LopeWale/home-hub/hardware/home-hub-enclosure-REV8.3mf

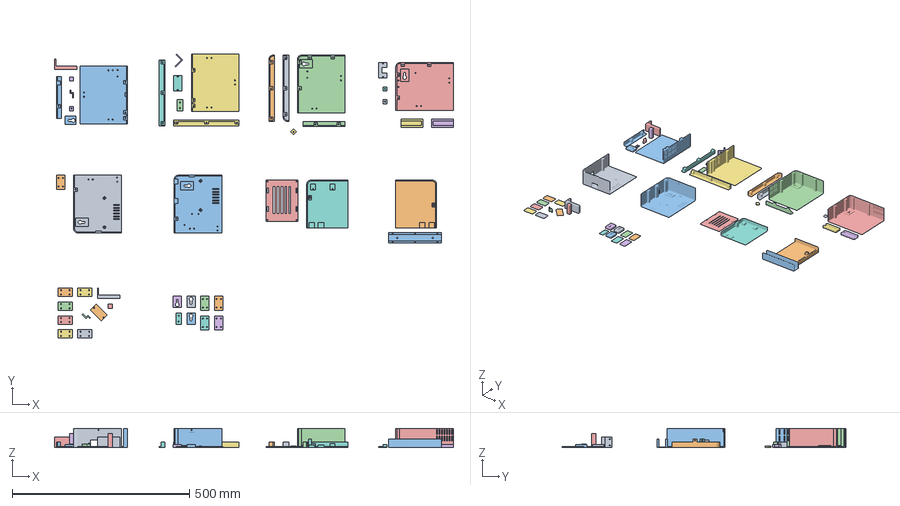
[picture p6: CAD file, 2026-10-14]
hardware/home-hub-enclosure-REV8.3mf
1124.1 x 800.8 x 54.0 mm
03-monitor-bottom-shoe.stl x 2
02-chassis-splice.stl x 11
01-rear-1-2.stl
04-monitor-rear-post.stl x 2
01-rear-2-2.stl
12-wall-spacer.stl x 4
13-exit-blank.stl x 2
01-rear-1-1.stl
01-rear-2-1.stl
11-bay-cover-splice.stl x 2
01-rear-1-3.stl
01-rear-2-3.stl
10-right-bay-cover-2.stl
10-right-bay-cover-1.stl
14-wall-cable-channel.stl
11-bay-cover-hook.stl x 2
12-wall-anti-lift-bracket.stl
08-front-bottom-right.stl
07-front-top-right.stl
08-front-bottom-left.stl
07-front-top-left.stl
09-front-left-lower.stl
09-front-left-upper.stl
06-open-pi-carrier.stl
04-monitor-side-stop-right.stl
04-monitor-side-stop-left.stl
13-exit-cable.stl
05-rear-shim-1mm.stl
05-rear-shim-4mm.stl
05-rear-shim-8mm.stl
05-rear-shim-2mm.stl
