LopeWale/home-hub/hardware/assembly/REV8-Interactive-Assembly.html

# REV8 / Explore the assembly

Your printed parts. Rotate, separate, and build one group at a time.

Visual assembly companion

## Build sequence

## Pull it apart 0%

TogetherExploded

Show monitor & Pi reference See through the monitor

## Find a printed part

Browse by shape ↗

Zoom to partPart onlyReset view

Drag to rotate · Scroll to zoom
Click a part to identify it.

Printed geometry comes from your saved 3MF. Monitor, Pi, cables, and any screw illustrations are schematic. Exploded spacing is for explanation, not fitting clearance.

3D viewFrontBack / screw accessTop+−Save picture

Click a part to see its name

Front = screen side · Back = wall side

## Selected part

Start with the six rear panels

Select a part in the model or list.

Color identifies the assembly group

Use the steps on the left. The explosion slider separates every printed component so you can see where it belongs.

Show where this goes

## Color key

Service cover: remove the two RIGHT-side screws, slide DOWN 8 mm, then pull forward. Disconnect the Pi's left-facing plugs before withdrawing the carrier.

# Find your piece by shape

Close ×

Select a shape to turn it around. Colors identify groups; your printed parts are black.
