LopeWale/home-hub/hardware/assembly/REV8-Picture-Assembly-Guide.pdf

# START / See the complete assembly

Colors help identify groups. All of your printed parts can remain black.

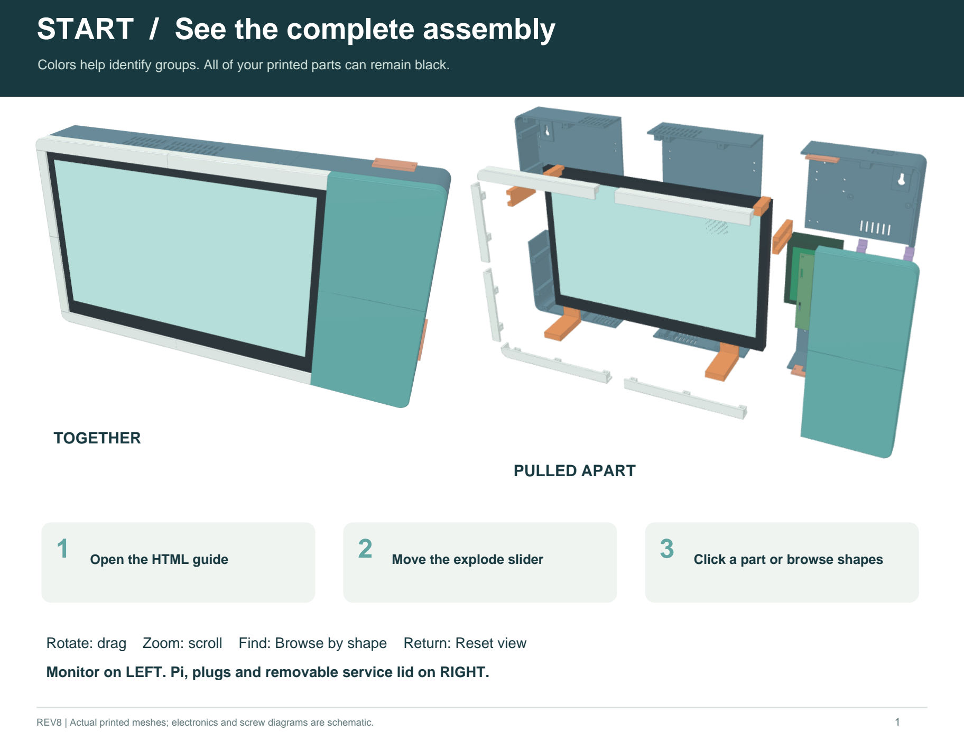
[picture p9: page 1]

REV8 | Actual printed meshes; electronics and screw diagrams are schematic. | 1

## TOGETHER

## PULLED APART

1 Open the HTML guide | 2 Move the explode slider | 3 Click a part or browse shapes

## Rotate: drag Zoom: scroll Find: Browse by shape Return: Reset view

Monitor on LEFT. Pi, plugs and removable service lid on RIGHT.

# 01 / Match the six rear panels

Front / screen side faces you. Top row = row 2; bottom row = row 1.

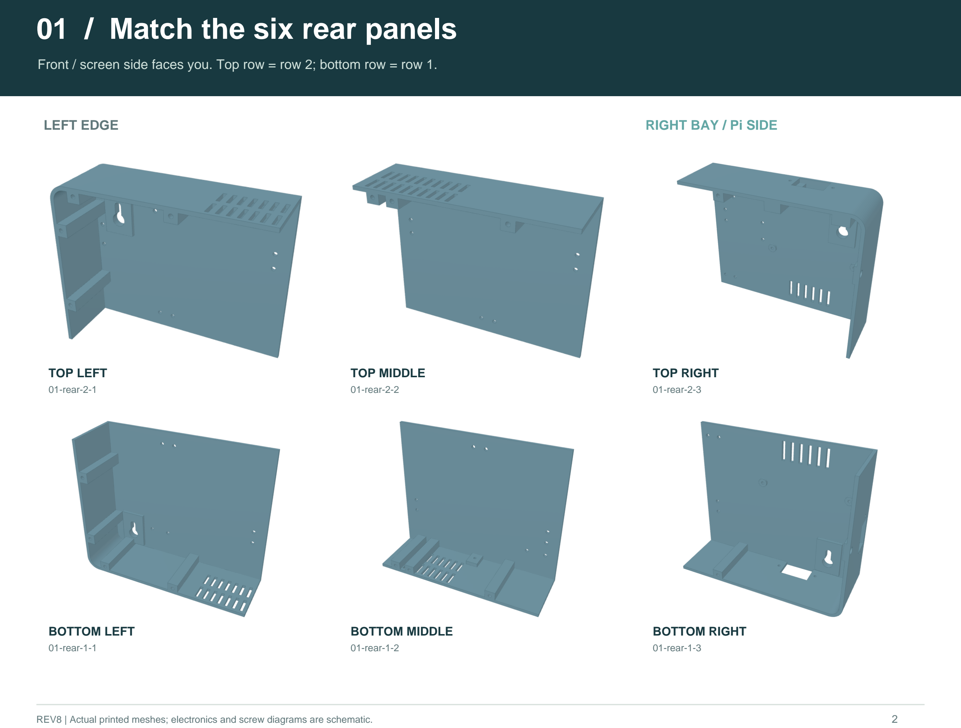
[picture p10: page 2]

REV8 | Actual printed meshes; electronics and screw diagrams are schematic. | 2

### TOP LEFT

01-rear-2-1

### TOP MIDDLE

01-rear-2-2

### TOP RIGHT

01-rear-2-3

### BOTTOM LEFT

01-rear-1-1

### BOTTOM MIDDLE

01-rear-1-2

### BOTTOM RIGHT

01-rear-1-3

LEFT EDGE | RIGHT BAY / Pi SIDE

# 02 / Join the seven seams

Gold = splice plates. Each plate uses FOUR M3 x 12 machine bolts and nuts.

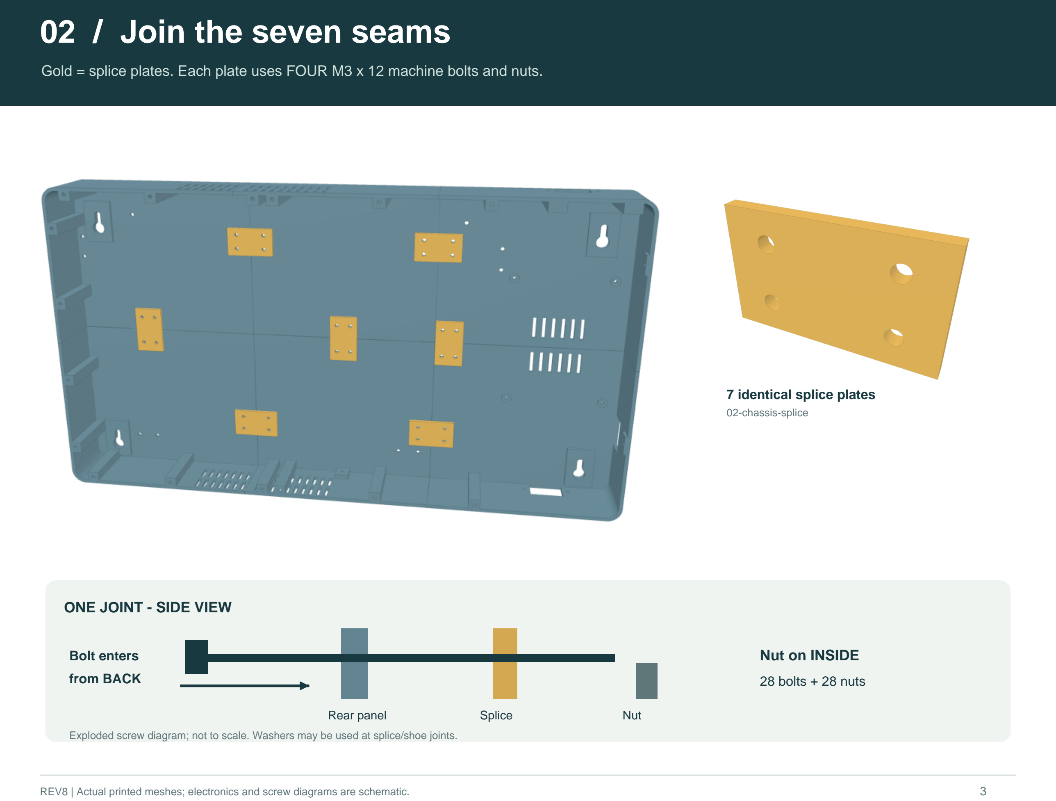
[picture p11: page 3]

REV8 | Actual printed meshes; electronics and screw diagrams are schematic. | 3

### 7 identical splice plates

02-chassis-splice

## ONE JOINT - SIDE VIEW

Rear panel | Splice | Nut

### Bolt enters from BACK

## Nut on INSIDE

### 28 bolts + 28 nuts

Exploded screw diagram; not to scale. Washers may be used at splice/shoe joints.

# 03 / Fit the monitor supports

Orange parts touch the monitor HOUSING through soft pads. Keep pressure off the glass.

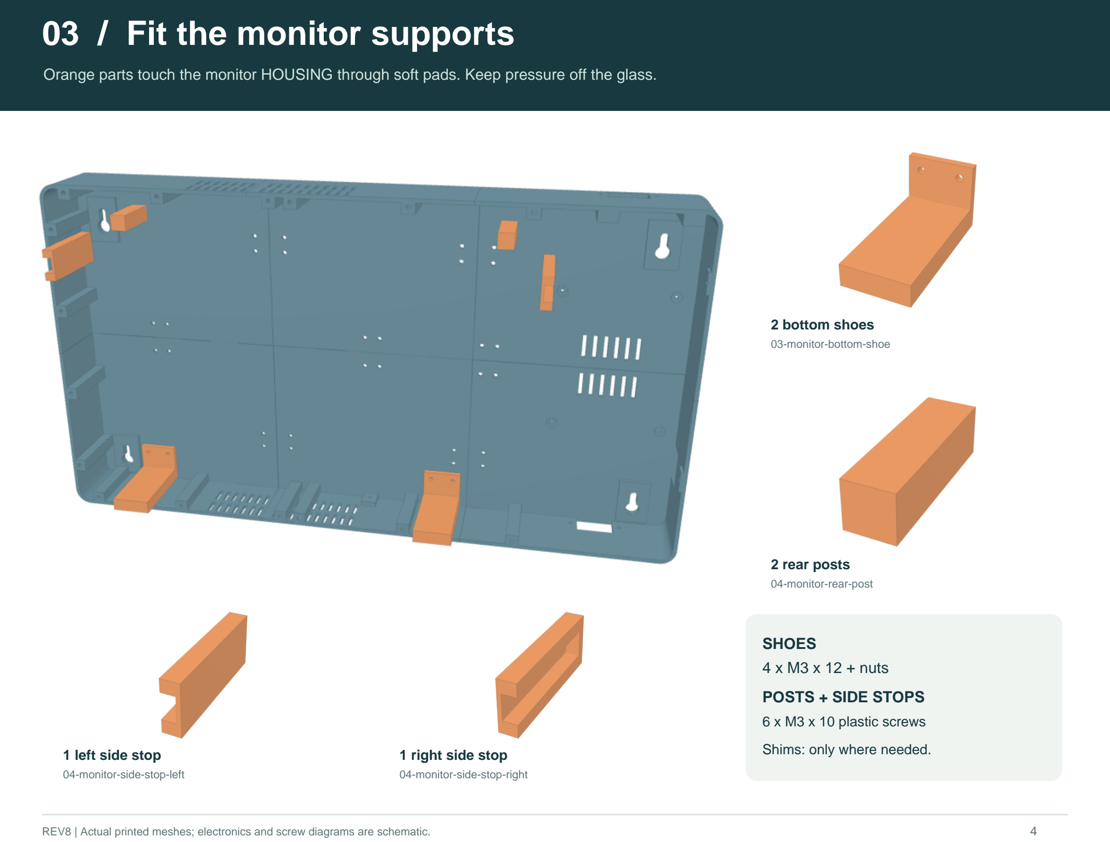
[picture p12: page 4]

REV8 | Actual printed meshes; electronics and screw diagrams are schematic. | 4

### 2 bottom shoes

03-monitor-bottom-shoe

### 2 rear posts

04-monitor-rear-post

### 1 left side stop

04-monitor-side-stop-left

### 1 right side stop

04-monitor-side-stop-right

## SHOES 4 x M3 x 12 + nuts

## POSTS + SIDE STOPS

### 6 x M3 x 10 plastic screws

Shims: only where needed.

04 / Seat the screen. Fit the trim.

Six pale frame pieces hold the housing. The service bay stays open on the right.

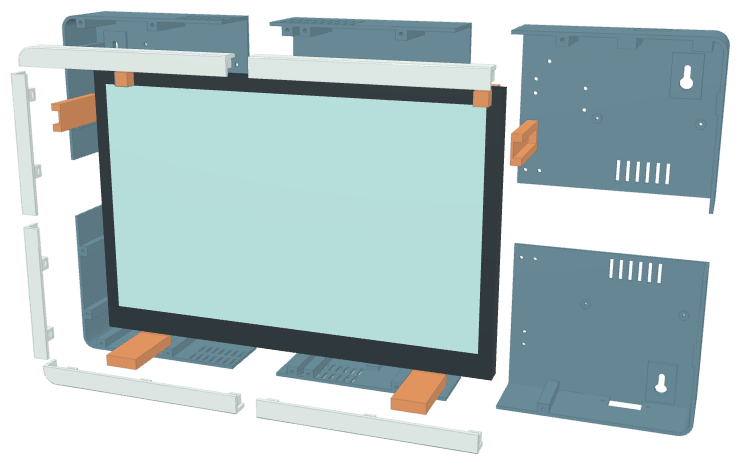
[picture p13: figure]

REV8 | Actual printed meshes; electronics and screw diagrams are schematic. | 5

## 16 FRAME JOINTS

## 1 Load nuts

into trim pockets.

## 2 Seat monitor

onto padded supports.

## 3 Fit trim pieces

Bolts enter from BACK.

## 16 x M3 x 12 machine bolts + 16 captive nuts

Use the rear driver tunnels. Support the screen while tightening; do not force the glass.

# 05 / Mount the Pi in the right bay

The carrier is fixed from the FRONT. Leave the adjacent connector sides open.

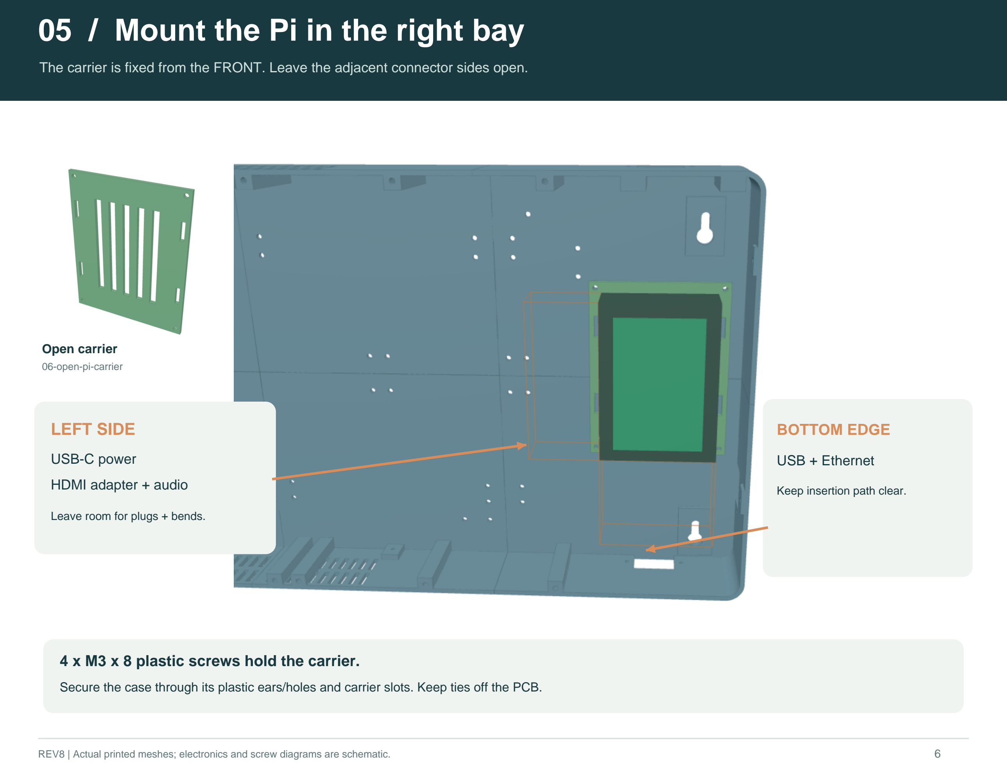
[picture p14: page 6]

REV8 | Actual printed meshes; electronics and screw diagrams are schematic. | 6

### Open carrier

06-open-pi-carrier

## LEFT SIDE

## USB-C power HDMI adapter + audio

Leave room for plugs + bends.

## BOTTOM EDGE

## USB + Ethernet

Keep insertion path clear.

4 x M3 x 8 plastic screws hold the carrier.

Secure the case through its plastic ears/holes and carrier slots. Keep ties off the PCB.

# 06 / Build the removable service lid

Join the two cover halves into one lid; hooks and backing plates stay attached to it.

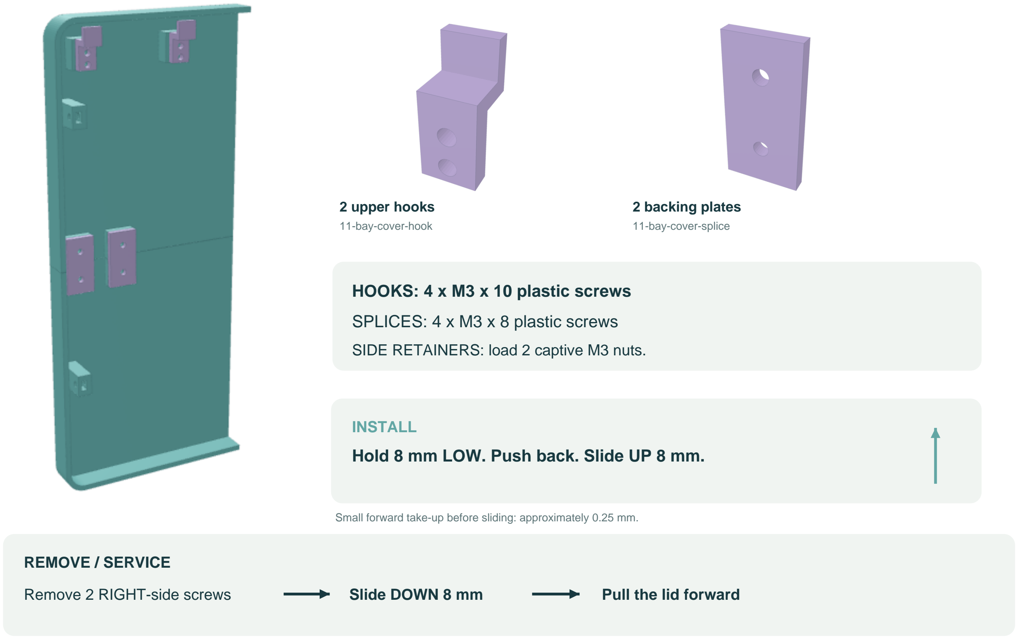
[picture p15: figure]
2 upper hooks; 11-bay-cover-hook; 2 backing plates; 11-bay-cover-splice; HOOKS: 4 x M3 x 10 plastic screws; SPLICES: 4 x M3 x 8 plastic screws; SIDE RETAINERS: load 2 captive M3 nuts.; INSTALL; REMOVE / SERVICE

REV8 | Actual printed meshes; electronics and screw diagrams are schematic. | 7

Hold 8 mm LOW. Push back. Slide UP 8 mm.

Remove 2 RIGHT-side screws | Slide DOWN 8 mm | Pull the lid forward

Small forward take-up before sliding: approximately 0.25 mm.

# 07 / Wall mounting and hidden wiring

View from the BACK: left and right appear reversed. Preserve access to the right-side lid screws.

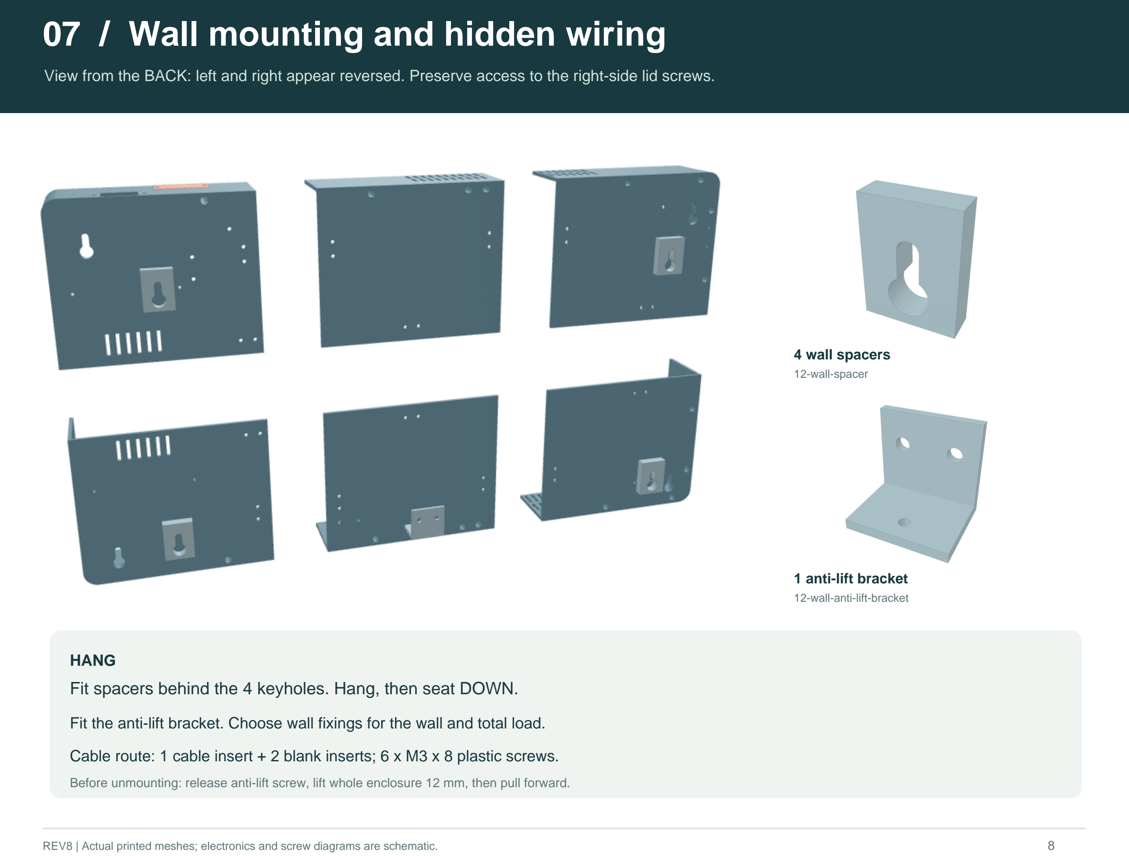
[picture p16: page 8]

REV8 | Actual printed meshes; electronics and screw diagrams are schematic. | 8

### 4 wall spacers

12-wall-spacer

### 1 anti-lift bracket

12-wall-anti-lift-bracket

## HANG

Fit spacers behind the 4 keyholes. Hang, then seat DOWN.

Fit the anti-lift bracket. Choose wall fixings for the wall and total load.

Cable route: 1 cable insert + 2 blank inserts; 6 x M3 x 8 plastic screws.

Before unmounting: release anti-lift screw, lift whole enclosure 12 mm, then pull forward.

# FIND / Match your loose parts by shape

Exact saved meshes. Optional shims and cable-channel base are marked below.

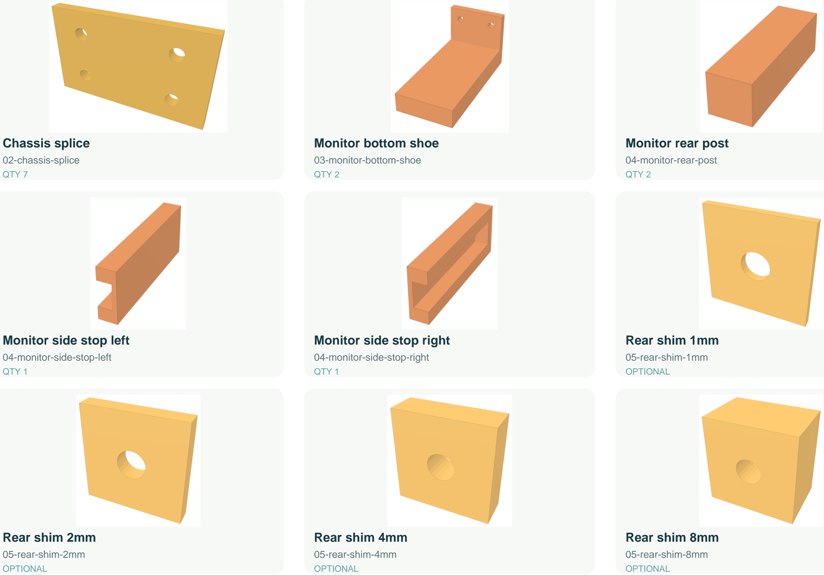
[picture p17: figure]
Chassis splice; 02-chassis-splice QTY 7; Monitor bottom shoe; 03-monitor-bottom-shoe QTY 2; Monitor rear post; 04-monitor-rear-post QTY 2; Monitor side stop left; 04-monitor-side-stop-left QTY 1; Monitor side stop right; 04-monitor-side-stop-right QTY 1; Rear shim 1mm; 05-rear-shim-1mm OPTIONAL; Rear shim 2mm; 05-rear-shim-2mm OPTIONAL; Rear shim 4mm; 05-rear-shim-4mm OPTIONAL; Rear shim 8mm; 05-rear-shim-8mm OPTIONAL

REV8 | Actual printed meshes; electronics and screw diagrams are schematic. | 9

# FIND / Match your loose parts by shape

Exact saved meshes. Optional shims and cable-channel base are marked below.

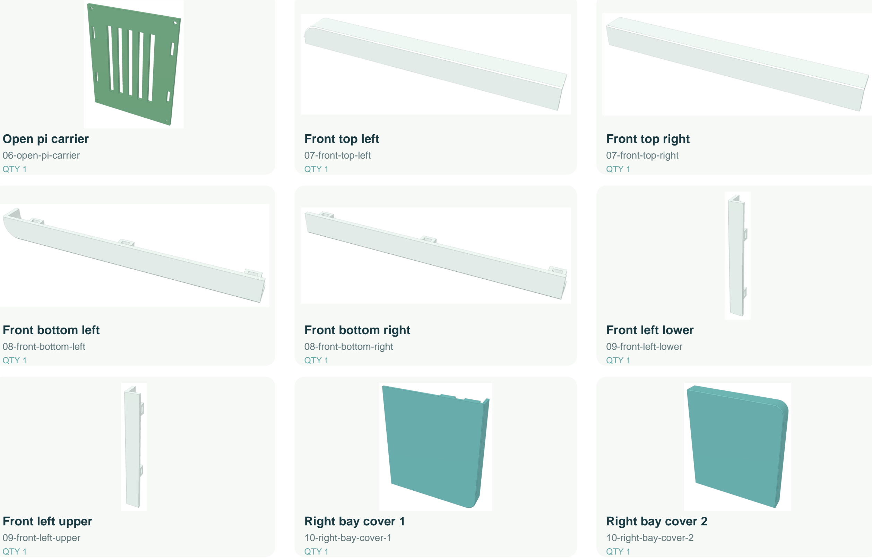
[picture p18: figure]
Open pi carrier; 06-open-pi-carrier QTY 1; Front top left; 07-front-top-left QTY 1; Front top right; 07-front-top-right QTY 1; Front bottom left; 08-front-bottom-left QTY 1; Front bottom right; 08-front-bottom-right QTY 1; Front left lower; 09-front-left-lower QTY 1; Front left upper; 09-front-left-upper QTY 1; Right bay cover 1; 10-right-bay-cover-1 QTY 1; Right bay cover 2; 10-right-bay-cover-2 QTY 1

REV8 | Actual printed meshes; electronics and screw diagrams are schematic. | 10

# FIND / Match your loose parts by shape

Exact saved meshes. Optional shims and cable-channel base are marked below.

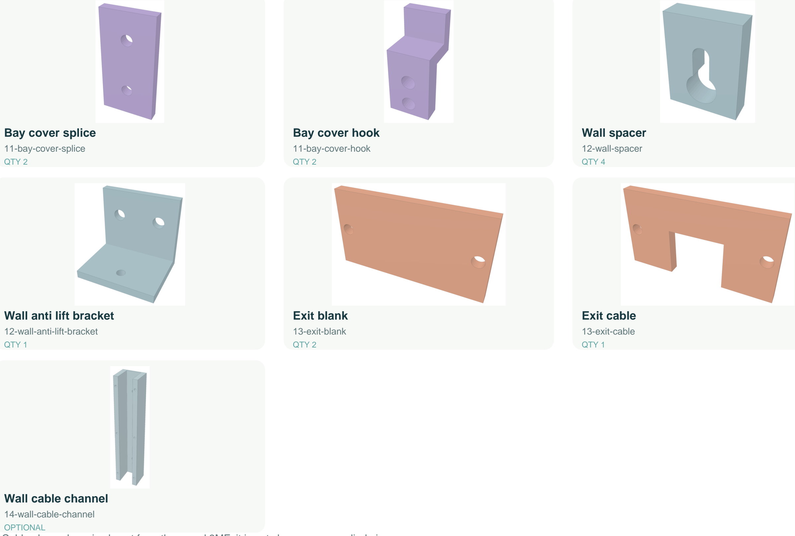
[picture p19: figure]
Bay cover splice; 11-bay-cover-splice QTY 2; Bay cover hook; 11-bay-cover-hook QTY 2; Wall spacer; 12-wall-spacer QTY 4; Wall anti lift bracket; 12-wall-anti-lift-bracket QTY 1; Exit blank; 13-exit-blank QTY 2; Exit cable; 13-exit-cable QTY 1; Wall cable channel; 14-wall-cable-channel OPTIONAL

REV8 | Actual printed meshes; electronics and screw diagrams are schematic. | 11

Cable-channel cap is absent from the saved 3MF; it is not shown as a supplied piece.
