LopeWale/home-hub/(commit log)

2026-10-14 Home Hub: first public release
    Wall-mounted touch screen hub on MagicMirror 2.38 and a Raspberry Pi 4:
    calendar and to-do lists, YouTube casting, sports scores and game details,
    a 3D globe with weather and local news, guest Wi-Fi QR, Bluetooth speaker,
    and a Tailscale-only admin page. Includes the REV8 3D printable enclosure
    (CC BY-NC-SA 4.0) and its assembly guides. Code under MIT.
    [home-hub-enclosure-REV8.3mf]
2026-10-17 Start: wait for the clock to be synchronized (up to 90 s)
    After a power cut the Pi 4 (no battery clock) booted with the previous
    day's time; MagicMirror started 4 s before systemd-timesyncd corrected it
    by about 19 hours, and the Sports and Globe pages did not load.
    Claude-Session: https://claude.ai/code/session_01CyDCso1SX64eaNqP7H6DFG
2026-10-30 Freeze safeguards: restart a dead screen, watchdog, kept logs, SD card warnings
    After the Pi froze for over a day (2026-10-25) and then would not boot
    because the SD card corrupted /usr/lib/aarch64-linux-gnu:
    - MMM-Guard exits MagicMirror when the page or GPU process dies or the
    page hangs for 60 s, so systemd restarts it instead of leaving a
    frozen screen. Every 10 minutes it also checks the kernel's ext4
    error count, under-voltage and free space, and shows a strip at the
    bottom of every page when one fails.
    - install.sh enables the Pi 4 hardware watchdog (15 s), keeps the
    system log across reboots (capped at 200 MB) and runs the health log
    as mm-health.service. The log gains c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
