LopeWale/home-hub/(notices)

Notices in the files:
hardware/assembly/REV8-Interactive-Assembly.html:
Three.js MIT license: The MIT License
Copyright © 2010-2023 three.js authors
